pentolope/PCBA_I2C_EnvSensor/i2c_env_sensor.kicad_pcb

## KiCad design i2c_env_sensor.kicad_pcb (2026-09-11)

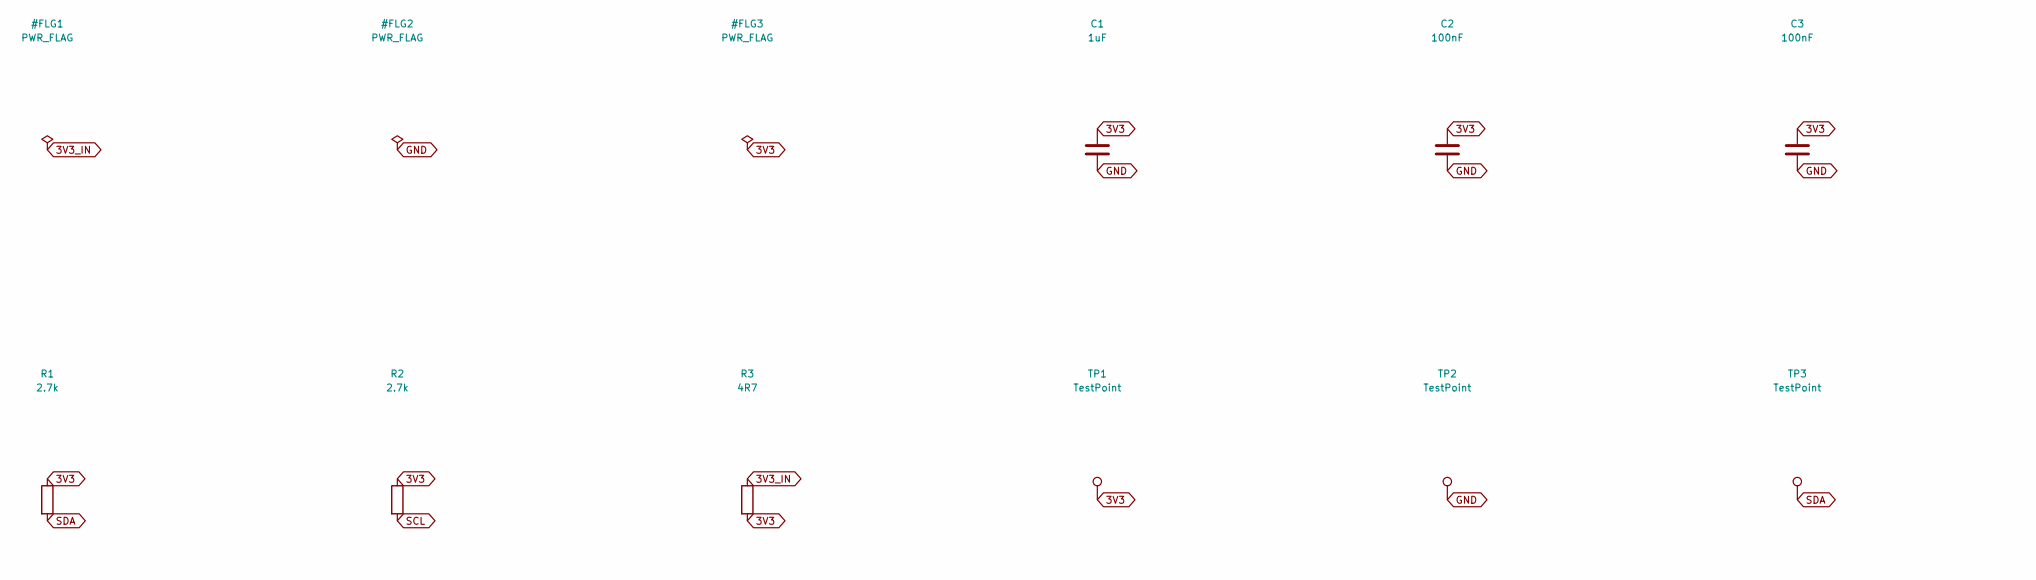
[picture p1: schematic i2c_env_sensor.kicad_sch, part in row 1, column 1]

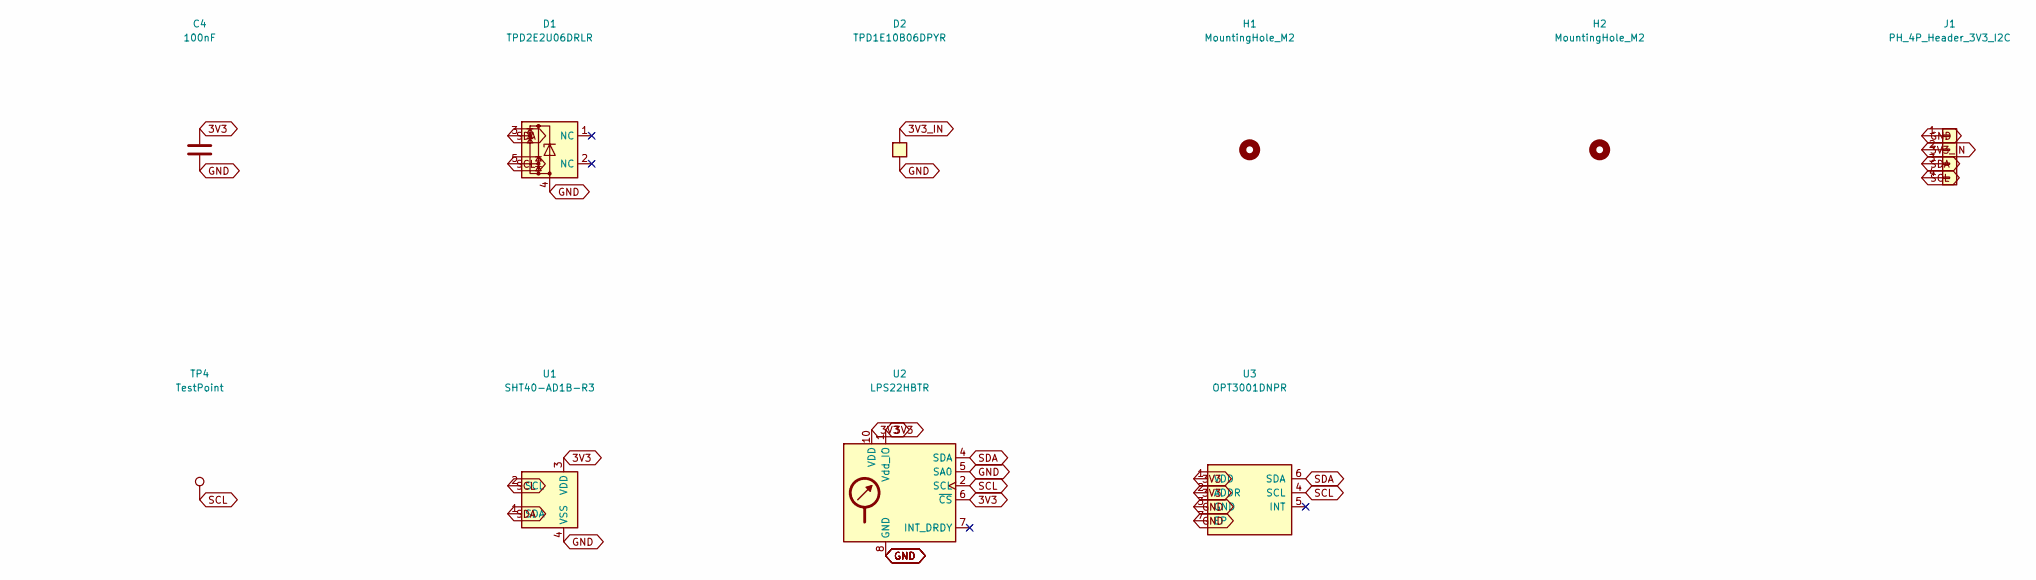
[picture p2: schematic i2c_env_sensor.kicad_sch, part in row 1, column 2]

Parts:
C1: 1uF; C_0603_1608Metric; MPN CL10A105KB8NNNC; LCSC C15849
C2, C3, C4: 100nF; C_0402_1005Metric; MPN CL05B104KO5NNNC; LCSC C1525
D1: TPD2E2U06DRLR; SOT-553; MPN TPD2E2U06DRLR; LCSC C1972959
D2: TPD1E10B06DPYR; Texas_X1SON-2_1.1x0.7mm_P0.7mm; MPN TPD1E10B06DPYR; LCSC C48260
H1, H2: MountingHole_M2; MountingHole_2.2mm_M2_DIN965
J1: PH_4P_Header_3V3_I2C; JST_PH_S4B-PH-K_1x04_P2.00mm_Horizontal; MPN S4B-PH-K-S(LF)(SN); LCSC C157926
R1, R2: 2.7k; R_0402_1005Metric; MPN RC0402FR-072K7L; LCSC C138017
R3: 4R7; R_0402_1005Metric; MPN CRCW04024R70FKED; LCSC C482197
TP1, TP2, TP3, TP4: TestPoint; TestPoint_Pad_D1.0mm
U1: SHT40-AD1B-R3; Sensirion_DFN-4_1.5x1.5mm_P0.8mm_SHT4x_NoCentralPad; MPN SHT40-AD1B-R3; LCSC C2848306
U2: LPS22HBTR; ST_HLGA-10_2x2mm_P0.5mm_LayoutBorder3x2y; MPN LPS22HBTR; LCSC C94049
U3: OPT3001DNPR; Texas_USON-6-1EP_2x2mm_P0.65mm_EP0.65x1.35mm; MPN OPT3001DNPR; LCSC C90462

Connections:
3V3: C1.1, C2.1, C3.1, C4.1, R1.1, R2.1, R3.2, TP1.1, U1.3 (VDD), U2.1 (Vdd_IO), U2.6 (~CS), U2.10 (VDD), U3.1 (VDD), U3.2 (ADDR)
3V3_IN: D2.2 (A2), J1.2, R3.1
GND: C1.2, C2.2, C3.2, C4.2, D1.4, D2.1 (A1), J1.1, TP2.1, U1.4 (VSS), U2.3 (GND), U2.5 (SA0), U2.8 (GND), U2.9 (GND), U3.3 (GND), U3.7 (EP)
SCL: D1.5, J1.4, R2.2, TP4.1, U1.2 (SCL), U2.2 (SCL), U3.4 (SCL)
SDA: D1.3, J1.3, R1.2, TP3.1, U1.1 (SDA), U2.4 (SDA), U3.6 (SDA)

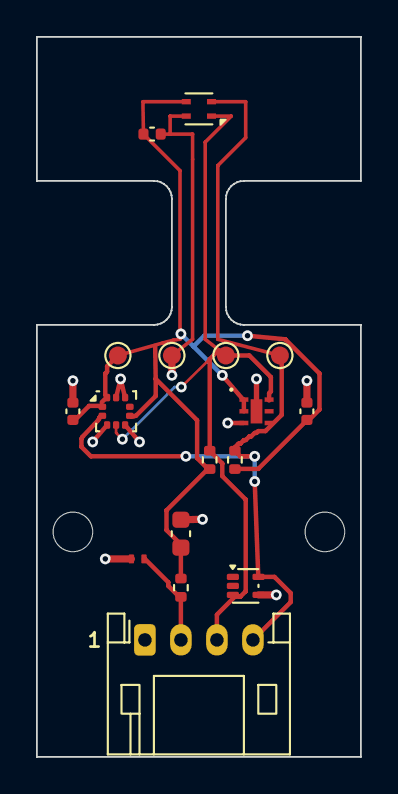
[picture p3: board i2c_env_sensor.kicad_pcb from above]

Board: 2 copper layers, 18.0 x 40.0 mm, 19 parts (0 on the bottom side), 5 nets.
