pentolope/PCBA_I2C_EnvSensor/(commit log)

2026-08-30 Seed benchmark board 02/32 from its supplied brief
    PCBA_I2C_EnvSensor is one of thirty-two boards in the PCBA_AutoDesignAndTest
    benchmark. This commit establishes the repository and nothing else:
    the board is not designed, and its absence is the intended state.
    BRIEF.md is the supplied brief, preserved byte for byte and
    authoritative. board/requirements.json splits it into fixed_requirements
    -- each carrying the verbatim brief text that substantiates it, bound to
    the SHA-256 of the brief's bytes -- and open_decisions, which are the
    design agent's to make and to record as choices. Promoting a decision
    into a requirement is the failure the split exists to prevent.
    docs/architecture.md is a w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
2026-08-30 Stop the scaffold claiming a check it does not perform
    An external review of the pushed benchmark found this repository asserting
    three things about itself that were not true as shipped.
    board/manifest.template.json said running the validator against it "will
    fail on the missing source". It does not: `run.py validate
    board/manifest.template.json` exits 0 and prints ACCEPTED, with all 36 gates
    NOT_APPLICABLE and no gate reading sources.pcb, so the absent board file is
    never noticed. The template now says exactly that, under verdict_warning,
    and docs/status.md and CLAUDE.md carry the same warning where a reader and
    an agent will actually meet it. The toolkit is behaving as designed - a gate
    w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
2026-08-30 Remove the claim-audit skill, and the instructions that called it
    Requested. .claude/skills/claim-audit/ is deleted, and with it every
    reference: CLAUDE.md's publishing discipline no longer names it, and the
    README layout table no longer advertises it.
    accountability-review kept calling it at step 3, which would have left the
    surviving skill invoking one that is not in the clone - the same
    dangling-instruction defect that put these skills in the repository in the
    first place. That step now states the claim-binding work directly: scan the
    drafts for claim-bearing words, and bind each to an artifact recomputed on
    the spot rather than to the process that produced it. The discipline is
    unchange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
2026-08-30 Finish removing claim-audit: the last prose reference to it
    accountability-review still explained itself with "that is why the claim
    audit runs first". Nothing runs first any more - the claim binding is step 3
    of this skill, and it runs before the review package is assembled, not
    before the review. The sentence now says that.
    Removing a skill is not done when its file is gone. It is done when nothing
    left in the repository tells a reader to go and find it.
2026-08-30 Review against this repository's own invariants, not another board's
    /accountability-review assembled its review package with a hardcoded list
    of "standing invariants", and that list belonged to a different project and
    an abandoned workflow: "never modify the authoritative Board A PCB" names a
    board that does not exist here, and "never touch main" and "no PRs"
    describe a process the opposite of this one -- every repository in this
    benchmark is developed on main and pushed directly.
    A reviewer handed those would hunt for violations of rules this project
    never adopted, and would do it with the authority of a stated invariant.
    Worse, the stale entries sat in the same sentence as live ones, so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
2026-08-30 Delete generated prose; keep the seed brief and machine-consumed config
    The seed pack already contained the human-authored specification for this
    board. Everything this repository added on top was a reinterpretation of it:
    a README and CLAUDE.md narrating the brief, an architecture worksheet of
    English questions, status and sources documents, a prose requirements
    document, and requirements.json - which restated the brief as English
    requirement strings and copied 20-odd verbatim quotations back out of a file
    sitting beside it in the same commit.
    None of that was consumed by anything. It was prose written so that a future
    reader would find the brief already interpreted, which is the interpret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
2026-09-02 Design the I2C environmental sensor pod
    Four measurands on one 3V3 bus: SHT40 temperature/humidity at 0x44,
    LPS22HB pressure at 0x5C, OPT3001 illuminance at 0x45. Addresses are
    strapped so no two devices answer the same one, and the strap net is what
    the address rule reads.
    The temperature and humidity sensor sits on an island reached only by a
    3 mm neck carrying four minimum-width traces and no pour, so the board's
    own dissipation lifts it 0.0026 K against the sensor's 0.2 C accuracy.
    Neck copper is generated rather than searched: its count and width ARE
    the isolation.
    A 4.7 ohm resistor damps the cable inductance into the pod's bulk
    capacitance; without it a live mate rings past the pres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
    [bom.csv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]
2026-09-02 Move the rail TVS to the cheaper package of the same part
    TPD1E10B06 in TI's X1SON-2 (DPY) rather than SOT-5X3 (DYA): the same
    die and the same datasheet, at $0.042 against $0.116 in ones, and 95,921
    in stock against 8,682. The land pattern is DPY0002A read from the
    datasheet already in evidence - two 0.3 x 0.5 mm pads 0.7 mm apart - and
    the part now carries its own symbol, because the generic TVS symbol's
    footprint filters are written for through-hole diode packages and pairing
    them with this land pattern reads as a parity mismatch.
    Checked every part against its manufacturer while here. TI publishes
    Active/Production for all three of its parts in the package addenda dated
    2025-2026, and S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
    [bom.csv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]
2026-09-02 Ignore KiCad's local project settings file
    *.kicad_prl holds per-user editor state, not design intent. KiCad rewrites
    it whenever the project is opened, which left the working tree differing
    from HEAD and blocked release-check on a file no result depends on.
2026-09-02 Bound the permittivity over the laminates this board can be built from
    The toolkit's catalog now states a dielectric constant for a two-layer
    laminate, 4.5, where before it published only the 4.6 core of the four- and
    six-layer constructions. The bus-capacitance claim leans on that number
    being a maximum: capacitance rises with permittivity, so the largest
    applicable value is what makes the claim an upper bound rather than an
    estimate, and an upper bound is what can settle a "<= 400 pF" requirement.
    A maximum bounds only the set it ranges over, and this one ranged over the
    wrong set. It read materials as though grouped by kind, but the catalog
    keys them by identity, so materials["prepreg"]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
    [i2c_env_sensor-B_Cu.gbr, i2c_env_sensor-B_Mask.gbr, i2c_env_sensor-B_Silkscreen.gbr, i2c_env_sensor-Edge_Cuts.gbr, i2c_env_sensor-F_Cu.gbr, i2c_env_sensor-F_Mask.gbr, i2c_env_sensor-F_Paste.gbr, i2c_env_sensor-F_Silkscreen.gbr]
2026-09-02 Refresh the fabrication selection against the current catalog
    fab/selection.json still recorded the catalog digest it was selected
    against before the two-layer dielectric constant was added, so a file
    inside this board's source closure named a catalog that no longer exists.
    Nothing reads that field back, which is why no gate caught it; it was
    wrong in the released state all the same.
    Regenerating also picks up what selection now says about this profile:
    that no two-layer construction is published but one can be composed from
    stated values. That is the fact this board has always been in, now
    recorded rather than left to be inferred from an empty candidate list.
    [i2c_env_sensor-B_Cu.gbr, i2c_env_sensor-B_Mask.gbr, i2c_env_sensor-B_Silkscreen.gbr, i2c_env_sensor-Edge_Cuts.gbr, i2c_env_sensor-F_Cu.gbr, i2c_env_sensor-F_Mask.gbr, i2c_env_sensor-F_Paste.gbr, i2c_env_sensor-F_Silkscreen.gbr]
2026-09-03 Record what this board needed from the toolkit and did not have
2026-09-03 Rebind the release to the phase 0 toolkit
    The toolkit now validates every manifest against its published schema
    and refuses vocabulary it does not implement, so the board-local gate
    list moves under the x_ extension prefix; gate-class selection
    (--only=design) supersedes it. Regenerated and revalidated against
    toolkit f4d3904: 23 gates pass, 13 report NOT_APPLICABLE, and
    the fabrication record now carries the source-closure member map, so
    future staleness names the input that moved.
    [i2c_env_sensor-B_Cu.gbr, i2c_env_sensor-B_Mask.gbr, i2c_env_sensor-B_Silkscreen.gbr, i2c_env_sensor-Edge_Cuts.gbr, i2c_env_sensor-F_Cu.gbr, i2c_env_sensor-F_Mask.gbr, i2c_env_sensor-F_Paste.gbr, i2c_env_sensor-F_Silkscreen.gbr]
2026-09-03 Retire the hand-written routing acceptance list
    The toolkit's design gate class replaces it: candidate acceptance now
    selects --only=design, expanded by the toolkit, so the set cannot rot
    as gates are added. The list leaves the manifest and the routing script that read it, and the
    release is regenerated under toolkit b441685, which also closes the
    review findings on the phase 0 seams: 23 gates pass, 13 report
    NOT_APPLICABLE.
    [i2c_env_sensor-B_Cu.gbr, i2c_env_sensor-B_Mask.gbr, i2c_env_sensor-B_Silkscreen.gbr, i2c_env_sensor-Edge_Cuts.gbr, i2c_env_sensor-F_Cu.gbr, i2c_env_sensor-F_Mask.gbr, i2c_env_sensor-F_Paste.gbr, i2c_env_sensor-F_Silkscreen.gbr]
2026-09-03 Close the adversarial findings that reached this board
    The unread keys the manifest carried are gone: tolerance_seconds is
    deleted, contact_semantics becomes the note annotation it always was,
    and the schema now refuses both by name. The routing acceptance
    selection regains ROUTE.PROVENANCE - the loop writes the record before
    judging, so record-board agreement is judged per candidate as it was
    under the hand-written list, and the acceptance tests now assert the floor of gates the loop depends on as well as the artifact-gate exclusions. Regenerated and revalidated under
    toolkit a0f53eb: 23 gates pass, 13 report NOT_APPLICABLE.
    [i2c_env_sensor-B_Cu.gbr, i2c_env_sensor-B_Mask.gbr, i2c_env_sensor-B_Silkscreen.gbr, i2c_env_sensor-Edge_Cuts.gbr, i2c_env_sensor-F_Cu.gbr, i2c_env_sensor-F_Mask.gbr, i2c_env_sensor-F_Paste.gbr, i2c_env_sensor-F_Silkscreen.gbr]
2026-09-03 Rebind the release to toolkit 0c051f2
    The toolkit keeps its CLI alive with no display and closes the third
    review round's findings; nothing in this board's own sources moved.
    23 gates pass, 13 report NOT_APPLICABLE.
    [i2c_env_sensor-B_Cu.gbr, i2c_env_sensor-B_Mask.gbr, i2c_env_sensor-B_Silkscreen.gbr, i2c_env_sensor-Edge_Cuts.gbr, i2c_env_sensor-F_Cu.gbr, i2c_env_sensor-F_Mask.gbr, i2c_env_sensor-F_Paste.gbr, i2c_env_sensor-F_Silkscreen.gbr]
2026-09-03 Rebind the release to toolkit 7f51066
    The panel-fix round widened the source closure to every staged design
    input and hardened the verdict binding, so the fabrication outputs and
    the recorded verdict are regenerated under the new toolkit. The
    transient .pcbqa-hold-* lock file is ignored.
    The board's .kicad_prl is a design input the toolkit stages for every
    check, so it is now tracked rather than gitignored - the source closure
    covers it and release readiness requires it in the tag.
    [i2c_env_sensor-B_Cu.gbr, i2c_env_sensor-B_Mask.gbr, i2c_env_sensor-B_Silkscreen.gbr, i2c_env_sensor-Edge_Cuts.gbr, i2c_env_sensor-F_Cu.gbr, i2c_env_sensor-F_Mask.gbr, i2c_env_sensor-F_Paste.gbr, i2c_env_sensor-F_Silkscreen.gbr]
2026-09-04 Delete the routing loop, declare the search, rebind to toolkit bd0ad78
    The private loop, tidy passes and the canonical serializer move to the
    toolkit; routing.search and routing.transforms declare what the deleted
    code hardcoded, with canonicalize: true keeping generated boards
    byte-stable. The toolkit's canonicalize namespace differs from the
    deleted board-local one, so the next regeneration rewrites every uuid -
    expected, and recorded here. layout.write() saves through the
    project-preserving save and calls the toolkit canonicalizer. The
    declaration is reserved-complement (the GND pour must be reserved);
    route --check proves the scope equals the recorded run's.
    The fabrication outputs are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
    [i2c_env_sensor-B_Cu.gbr, i2c_env_sensor-B_Mask.gbr, i2c_env_sensor-B_Silkscreen.gbr, i2c_env_sensor-Edge_Cuts.gbr, i2c_env_sensor-F_Cu.gbr, i2c_env_sensor-F_Mask.gbr, i2c_env_sensor-F_Paste.gbr, i2c_env_sensor-F_Silkscreen.gbr]
2026-09-04 Complete the first owned routing cycle: search, replay, adopt, proven
    The re-review demanded a real consumer run the toolkit's owned loop
    end to end. This board did, against the real pinned router:
    - The first search refused all three candidates honestly -
    ROUTE.TINY_SEGMENTS named 11 sub-floor fragments the declared
    transform list did not fold.
    - The declaration widened (snap_to_pad_anchor, fold_subfloor, dedupe,
    trim_dangling_ends added); `route --replay` re-judged the recorded
    candidates through the changed transforms without re-searching, and
    attempt 2 was accepted and adopted, digest-verified.
    - A fresh search->accept->adopt then completed in one run from the
    regenerated pr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
    [i2c_env_sensor-B_Cu.gbr, i2c_env_sensor-B_Mask.gbr, i2c_env_sensor-B_Silkscreen.gbr, i2c_env_sensor-F_Cu.gbr, i2c_env_sensor-F_Mask.gbr, i2c_env_sensor-F_Paste.gbr, i2c_env_sensor-F_Silkscreen.gbr, i2c_env_sensor-PTH.drl]
2026-09-04 Re-record the owned route under per-input design bindings
    The toolkit's third review round made the routing record bind every
    design input by its own digest (plus the manifest with
    routing.transforms removed) and made `route --check` and
    ROUTE.PROVENANCE enforce those bindings after adoption. This board
    re-ran the full owned cycle under that schema, against the real
    pinned router:
    - The pre-route board regenerated byte-identical for the third time
    (d9e4882b...), then `run.py route --adopt` searched: attempt 1
    refused honestly on ROUTE.GEOMETRY_HYGIENE, attempt 2 accepted and
    adopted (797a2fdb...). The record carries the 1/2 accept rate - the
    router remains not run-to-run determinist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
    [i2c_env_sensor.kicad_pcb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]
2026-09-05 Refresh the fabrication binding under the reviewed toolkit
    The toolkit's fourth review round pinned the routing judgment to its
    recorded policy at the read site, fixed the router-summary shape the
    reconciliation reads, and extended post-adoption enforcement to the
    manifest digest and recorded plan; nothing in this board's own sources
    changed. Rebuilt and revalidated so the committed verdict and closure
    name the reviewed toolkit state.
2026-09-05 Refresh the fabrication binding under the reviewed toolkit
    The toolkit's fifth review round closed its last blocker: with a
    recorded binding declared, every acceptance gate now reads the
    verified staged design instead of live pathnames. Nothing in this
    board's own sources changed. Rebuilt and revalidated so the committed
    verdict and closure name the reviewed toolkit state.
2026-09-05 Re-record the owned route under acceptance-input bindings
    The toolkit's sixth review round made the routing record bind every
    auxiliary file the acceptance gates consume - not just the native
    KiCad closure. This board re-ran the full owned cycle under that
    schema, against the real pinned router:
    - The pre-route board regenerated byte-identical for the fourth time
    (d9e4882b...); attempt 1 refused, attempt 2 accepted and adopted
    (e309fcfd...), the 1/2 accept rate recorded honestly.
    - The record now binds SIX acceptance inputs by digest - BRIEF.md
    (with its documentation-glob membership), fab/physical_inputs.json,
    and the four simulation scenarios - alongside the design closure,
    mani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
    [i2c_env_sensor.kicad_pcb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]
2026-09-05 Adopt Phase 2 evidence governance: claims, policy, dependencies bound
    The toolkit's Phase 2 made the evidence program declarative and
    enforced; this board is the first full adopter:
    - design/claims.py emits generated/claims.json through the toolkit's
    claim-document builder; PROV.DERIVED_DOCUMENTS re-runs it and refuses
    a stale commit (it caught exactly that on its first run, when the
    adopted copper changed the SCL capacitance claim).
    - The three mis-ordered-mate unknowns move from a test-file constant to
    manifest policy: claims.unsupported.permitted, owned and expiring,
    judged by CLAIM.POLICY. The claims cite only frozen documents -
    the 'design-source' pseudo-document is gone, a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
    [i2c_env_sensor.kicad_pcb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]
2026-09-05 Refresh the fabrication binding under the committed Phase 2 toolkit
    The toolkit's evidence-governance commit is a source-closure member,
    so the committed artifacts and verdict re-bind to it. Nothing in this
    board's own sources changed in this commit.
2026-09-05 Re-record the route with the claims document bound as a derived acceptance input
    The adversarial review closed the derived-document exclusion: the
    record now binds generated/claims.json by digest like every other
    acceptance input and lists it as derived. Its honest post-adoption
    regeneration is excused by the generator-freshness check - proven
    live here: adopt, regenerate, and route --check prints OK with the
    drift excused because the current bytes are exactly what
    design.claims produces from the tracked tree with the target hidden.
    A hand edit would still refuse. This run also surfaced and fixed the
    staging's dangling relative toolkit symlink.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
    [i2c_env_sensor.kicad_pcb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]
2026-09-05 Refresh the fabrication binding under the review-fixed Phase 2 toolkit
    The first adversarial review round hardened the evidence machinery
    (derived documents rebound, staged generators, advisory surfaced);
    nothing in this board's own sources changed in this commit.
2026-09-05 Re-record the owned route under the dated manifest
    The review-date additions moved the manifest, and ROUTE.PROVENANCE
    correctly refused the old record - the policy that accepted the
    adopted copper must be the policy the tree declares. Re-ran the owned
    cycle: pre-route board regenerated byte-identical, searched, adopted,
    claims regenerated from the adopted copper and excused by generator
    freshness at check.
    [i2c_env_sensor.kicad_pcb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]
2026-09-05 Adopt the round-3 corrections and re-record the route under the widened closure
    The claim document joins the source closure, which moves the manifest,
    which correctly invalidates the routing record - re-ran the owned
    cycle. The post-adoption claims regeneration prints as an EXCUSED row
    in route --check now: the drift escape is recorded, never silent.
2026-09-05 Refresh the fabrication binding: round-3 verdict rendering
    The toolkit's open-item rendering commit is a closure member; this
    board's committed verdict re-binds to it. No board sources changed.
2026-09-05 Refresh the fabrication binding: fourth-round evidence fixes
    The toolkit now lists register methods still required that no
    dependency owns as open items in the policy state - a passing claim
    establishes the number, never the separately declared method - and the
    refreshed validation record carries whatever this board honestly owes.
2026-09-05 Refresh the fabrication binding: fifth-round toolkit
    Domain enforcement now owns timing's evidence gates, refuses vacuous
    simulation declarations, and judges device-parameter validity from the
    operating point; nothing on this board changes beyond the closure.
2026-09-05 Refresh the fabrication binding: sixth-round toolkit
    PROV.DEVICE_PARAMETERS now judges applicability from the citation
    rather than from the presence of a validity range - a record with no
    stated range has no supported range. Nothing on this board changes
    beyond the closure; its citations already state their operating points.
2026-09-05 Refresh the fabrication binding against the Phase 3 toolkit
    Phase 3 advanced the toolkit, which is a source-closure member, so the
    committed reports and the validation record are re-made against it.
    This board froze no physical input that needed re-freezing: its records
    either cite no approved-catalogue digest, or - for board 02 - are bound
    by a routing record whose acceptance inputs they are, and re-freezing
    them would invalidate an adoption that cannot currently be re-run
    because the router writes no summary in this environment. The digest a
    frozen record carries states the catalogue it WAS resolved from, which
    remains true, and the value it holds is identical in the current
    catalogue.
    C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
2026-09-05 Refresh the fabrication binding against the Phase 3 toolkit
    This board does NOT yet record its decision about the five evidence
    domains Phase 3 added - thermal, current capacity, power integrity,
    differential pairs and reference continuity - and its release therefore
    reports requires-additional-evidence, naming each one as undecided.
    That is the honest state rather than an oversight. Recording a decision
    means editing the manifest, and this board's routing record binds the
    manifest digest: the policy that accepted its adopted copper must be the
    policy the tree declares. Re-recording needs an owned search, and the
    router in this environment completes without writing the --json-out
    summary th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
2026-09-05 Refresh the fabrication binding against the reviewed Phase 3 toolkit
    The toolkit is a source-closure member, so four rounds of adversarial
    review over Phase 3 mean the committed reports and the validation record
    are re-made against the code that now exists. Nothing about this board
    changed.
2026-09-06 Rebuild the artifacts against the fifth-review toolkit
    No verdict moves and no gate changes status: the round closed defects in
    the current, PDN, coverage and arc paths, and what this board exercises
    of them it already exercised correctly. The artifacts are refreshed so
    the recorded run names the toolkit commit that produced it rather than
    one four fixes behind.
2026-09-06 Settle every evidence domain the policy layer now requires
    policy.py grades a verdict on five states and holds every implemented
    domain to a decision: declared, or declined on the record with a reason.
    This board's release_profile predates the five physics domains, so all
    five read as silence, and silence is not a decision.
    Declared, both passing against real copper:
    power_integrity 3V3 solved on its own copper, worst drop 0.219 mV
    against a 10 mV budget; the return through the neck
    0.148 mV. The budget is under 1% of the smallest
    supply headroom any fitted part holds, so a rail
    inside it can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
2026-09-06 Record the routing-cycle defects this round exposed
    Four of the six requests are one problem: a routing record that cannot be
    reproduced. The search will not run from an adopted board, the only source
    it can run from was never committed, four identical searches drew three
    different accepted candidates, and the record binds the whole manifest by
    file hash - so an ordinary manifest edit becomes a design change.
2026-09-06 Re-record the route from the adopted board; five domain decisions reach the record; fabrication-ready
    The routing record bound the manifest that predated the five Phase 3
    domain decisions, and the remedy its own message prescribes - "rerun the
    owned search to re-record" - could not run: the search stages from the
    adopted board, the router legitimately had nothing to do, and its
    unaccounted exit was refused three times over. TOOLKIT_REQUEST_2.md 1.1
    asked for exactly the fix that landed: the router's nothing-to-do return
    now writes the --json-out tally it prints, the wrapper accepts
    status=already_connected as an accounted no-op, and the candidate - the
    board passed through - is transformed a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
    [i2c_env_sensor.kicad_pcb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]
2026-09-06 Rebuild the artifacts against the review-response toolkit
    No verdict moves and no gate changes status. The round closed the
    island-barrel channel in the PDN mesh, scoped the thermal copper
    ceiling to a named pad, and corrected two verdict texts; what this
    board exercises of them it already exercised correctly, and the refresh
    binds the record to the toolkit commit that produced it.
2026-09-06 Rebuild the artifacts against the second-pass toolkit
    No verdict moves and no gate changes status; the refresh binds the
    record to the toolkit commit that produced it.
    Correcting one sentence of ba682c2 on the record, per the adversarial
    review's measurement of this board's own diff: of the 535 UUIDs the
    canonicalize pass recomputed, only 83 landed on a different value (the
    other two removed lines belong to the two collapsed segments), and the
    pass's 220 reorderings left the surviving object order identical - the
    counters named the work the pass did, not the diff it produced.
2026-09-06 Rebuild the artifacts against the fragility-knob toolkit
    No verdict moves and no gate changes status. The toolkit pins
    KICAD_PLANE_FRAGILITY_COST=0 for every FUTURE owned search - KiCad's
    zone filler is a thread race the field inherited, core pinning
    measurably does not close it, and disabling the field is deterministic
    by construction. This board's adopted route and record are untouched:
    the knob binds searches, not validations, and a replay of the old
    record now refuses the environment check as it should. The refresh
    binds the artifacts to the toolkit commit that produced them.
2026-09-07 Rebuild the artifacts against the fill-oracle-account toolkit
    No verdict moves and no gate changes status. The wrapper now refuses a
    router summary that cannot account for which pour geometry its
    fragility field used; this board's adopted route and record are
    untouched, and the refresh binds the artifacts to the toolkit commit
    that produced them.
2026-09-07 Rebuild the artifacts against the upstream-merged toolkit
    No verdict moves and no gate changes status. The pinned router advanced
    through 254 upstream commits (grid_router v0.22.0, the #831 fill-oracle
    account the wrapper now reads, the --clearance semantics split); this
    board's adopted route and record are untouched, future searches inherit
    the new semantics, and the refresh binds the artifacts to the toolkit
    commit that produced them.
2026-09-11 Retire this board's toolkit request files
    Removed at the operator's direction. The program rule is that a request
    is closed by deletion rather than by a status note, and the toolkit
    work these asked for has been landing across phases 0 to 4; the files
    themselves stay readable in this repository's history, which is where a
    closed request belongs.
2026-09-11 Settle the two Phase 4 domains; rebind the fab inputs to the current catalog
    The policy layer grew `lifecycle` and `assembly_process`, and silence in
    either is not a decision. Both are declared rather than declined,
    because BRIEF.md states the requirement each one implements: "the
    reflow profile shall suit each fitted package, and washing shall be
    omitted where a fitted sensor forbids it", and "every part
    distributor-stocked in production quantity". Nothing on this board
    checked either sentence until now.
    assembly_process. One reflow pass at 245 C on the top side, no_clean,
    with J1 - a through-hole side-entry post that takes no stencil paste -
    in the hand_solder exception set. Every placed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
    [i2c_env_sensor-B_Cu.gbr, i2c_env_sensor-B_Mask.gbr, i2c_env_sensor-B_Silkscreen.gbr, i2c_env_sensor-Edge_Cuts.gbr, i2c_env_sensor-F_Cu.gbr, i2c_env_sensor-F_Mask.gbr, i2c_env_sensor-F_Paste.gbr, i2c_env_sensor-F_Silkscreen.gbr]
2026-09-11 Fit resistors whose maker states a lifecycle, and close BOM.LIFECYCLE
    The UNI-ROYAL thick-film parts were the only two of ten whose status
    nobody publishes - not the manufacturer, not LCSC, not JLCPCB, not any
    distributor carrying a Part Status field - so `unestablished` was the
    honest record and unknown is not PASS. Both are replaced by parts whose
    maker does state one.
    R1, R2 0402WGF2701TCE -> YAGEO RC0402FR-072K7L C25885 -> C138017
    R3 0402WGF470KTCE -> Vishay Dale CRCW04024R70FKED C25121 -> C482197
    Same resistance, same +/-1%, same 0402 land pattern, same 62.5 mW and
    50 V envelope, same -55 to 155 C range. The bodies are 1.0 x 0.5 mm as
    before and 0.05 mm shorter (0.35 +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
    [bom.csv, i2c_env_sensor.kicad_pcb, i2c_env_sensor.kicad_sch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]
2026-09-12 Measure the flow instead of claiming it, and stop naming the wrong warehouse
    Phase 5 reaches this board in one place: `flow_repeatability` joins the
    evidence-domain vocabulary, so silence about how this board's copper was
    arrived at stops being a decision. The other three items do not apply -
    no evidence here is a digitised curve, no interface on a 100 kHz
    single-ended bus needs a full-wave region, and the project declares no
    netclass beyond Default, so DRC.NETCLASS_COHERENCE has no membership to
    mis-bind and says so.
    The domain is declared, not declined. This copper came out of the
    declared candidate search, and the plan's rule is that "this board
    routes clean" is then a statement about a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
